nishiiba/Peghammer/README.md

# Peghammer  
Peghammerは漫画／イラスト用の自作無線左手デバイスです  

詳細は[ビルドガイド](docs/Index.md) をご確認下さい

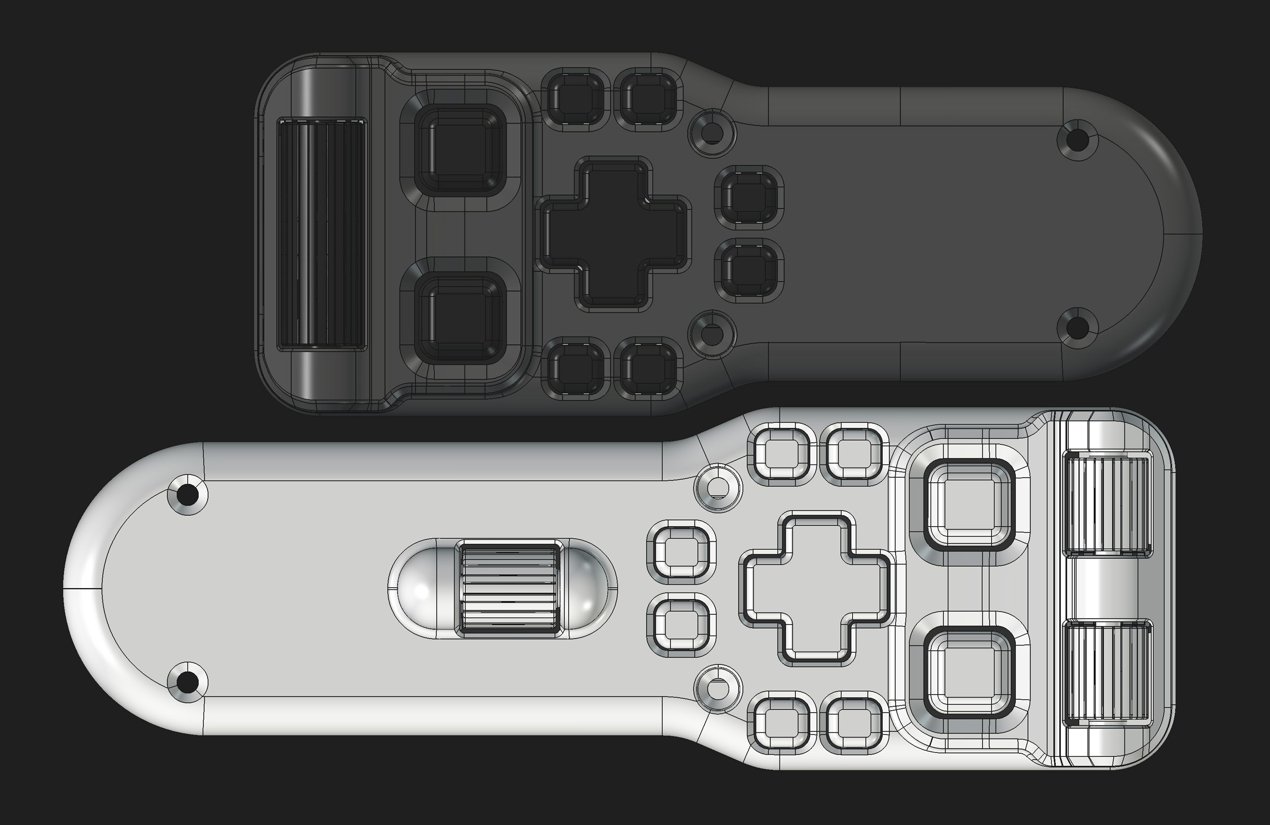
[picture p1: docs/image/top.jpg]
