nishiiba/Peghammer/PCB_3DP/README.md

## Peghammer – ハードウェア設計（PCBおよび3Dパーツ）

このディレクトリにはPeghammerのハードウェア設計ファイルが含まれています。

## 内容

- 基板データ（ガーバーファイル、ドリルファイルなど）
- 3Dモデルデータ（STL）

## ライセンス（ハードウェア設計）

このディレクトリにあるPeghammerのすべてのオリジナルハードウェア設計ファイル  
（PCB設計データおよび関連するオリジナルアセットを含む）はCC BY 4.0に基づいて公開されています。  

自由な利用: 複製、配布、商用利用、改変（改造・設計変更など）が可能です。  
主な条件: 利用時は必ず著作権者の表示を行ってください。また、改変した場合はその旨を明記してください。

---

## 謝辞／第三者提供資料

このハードウェア設計にはそれぞれの著作者の知的財産である  
第三者提供のフットプリントおよび回路図シンボルが含まれています。

これらの第三者提供資料はそれぞれのライセンスに従って使用されており  
本プロジェクトのCC BY 4.0ライセンスの対象外です。

これらの資料に関するすべての権利は元の作成者に帰属します。

クレジットは以下のとおりです。

###  BLE Micro Pro Assets (Footprints and Symbols)

BLE Micro Pro資料（フットプリントおよびシンボル）  
資料：MCUフットプリント、回路図シンボル  
作成者：sekigon-gonnoc  
ソース：https://github.com/sekigon-gonnoc/BLE-Micro-Pro/tree/master/bmp-boost  
ライセンス：MITライセンス  

## 免責事項（Disclaimer）

本ビルドガイド（以下「本ガイド」）に掲載された情報および配布データに基づいて作業を行う際は  
以下の免責事項を必ずお読みいただき同意の上で実施してください。

### 1. 設計データの現状有姿提供と無保証

* 本ガイドで配布・公開している各種設計データ  
（ガーバーデータ、3Dプリント用ケースデータ等以下「本データ」）  
はオープンハードウェアライセンス **CC BY 4.0** に基づいて提供されています。

* 本データは「現状有姿（As-Is）」で提供され明示・黙示を問わず  
その正確性、完全性、特定の目的への適合性あるいは動作の保証を含むいかなる種類の保証も行いません。

### 2. 製造・利用における自己責任

* 本データを利用してサードパーティ（基板製造メーカー、3Dプリントサービス等）への発注製造  
および組み立てを行う行為はすべて利用者の責任と費用において行ってください。

* データに起因する製造ミス、基板の不良、発注費用の損失  
あるいは組み立て中・使用中に発生したトラブルについて作成者は一切の責任を負いません。

### 3. 3Dプリントケースに関する免責

* 配布する3Dデータ（STL、STEP等）は作成者の環境で適合を確認したものですが  
利用者が使用する3Dプリンターの機種、スライサー設定、素材（フィラメント）の種類、収縮率  
または委託工場の仕様等によって印刷精度や仕上がりが異なります。  
ケースが基板（PCB）やスイッチと完全に嵌合（フィット）することを保証するものではありません。
 
* 素材の収縮や印刷誤差によりネジ穴の調整やヤスリがけ等の後加工が必要になる場合があります。  
これらの調整は利用者の責任において行ってください。

* 3Dプリントパーツの強度、耐熱性、経年劣化による破損  
または印刷失敗に伴うフィラメント費用の損失等について作成者は一切の責任を負いません。

### 4. 乾電池駆動に関する安全上の注意

* 本設計は乾電池駆動を想定しています。

* **充電式電池（ニッケル水素電池など）を装着した状態でUSBケーブルをPC等に接続して充電を行わないでください。**  
液漏れ、発熱、破裂、火災、および接続機器（PC等）の破損の原因となります。  

* 電池の極性（プラス・マイナス）を逆にして装着した場合の回路の破損や  
それに伴う事故・ケガ等について、当方は一切の補償をいたしません。

### 5. 損害賠償の不保持

* 本データおよび本ガイドの情報を利用したことにより生じた直接的・間接的な損害  
（キーボードの破損、接続機器の故障、データの損失、ケガ、火災など）について  
作成者は利用者または第三者に対して一切の法的な責任を負いません。
