nishiiba/Peghammer/docs/repl.md

# 部品が在庫切れの場合

<br>

①代替部品に変更  
②在庫切れ部品の予約注文  
③基板発注をPCBWAYに変更する  
④在庫切れ部品を自分で調達する

以上4つの方法があります

<br>

## ①代替部品に変更する
<br>

**代替部品に変更可能なのは以下の2箇所のみです**  

<br>

トリガー用スイッチ　C79178(標準部品) → C713479(代替部品)  
5方向スイッチ　C202415(標準部品) → C209766(代替部品)

<br>

トリガー用スイッチに代替部品を使う場合は  
スイッチキャップも変更が必要になります  
**[ここからc_repl.zipをダウンロード](https://github.com/nishiiba/peghammer/tree/main/PCB_3DP)**

<br>
<br>

欠品している部品は右端の部品編集から変更を行います  

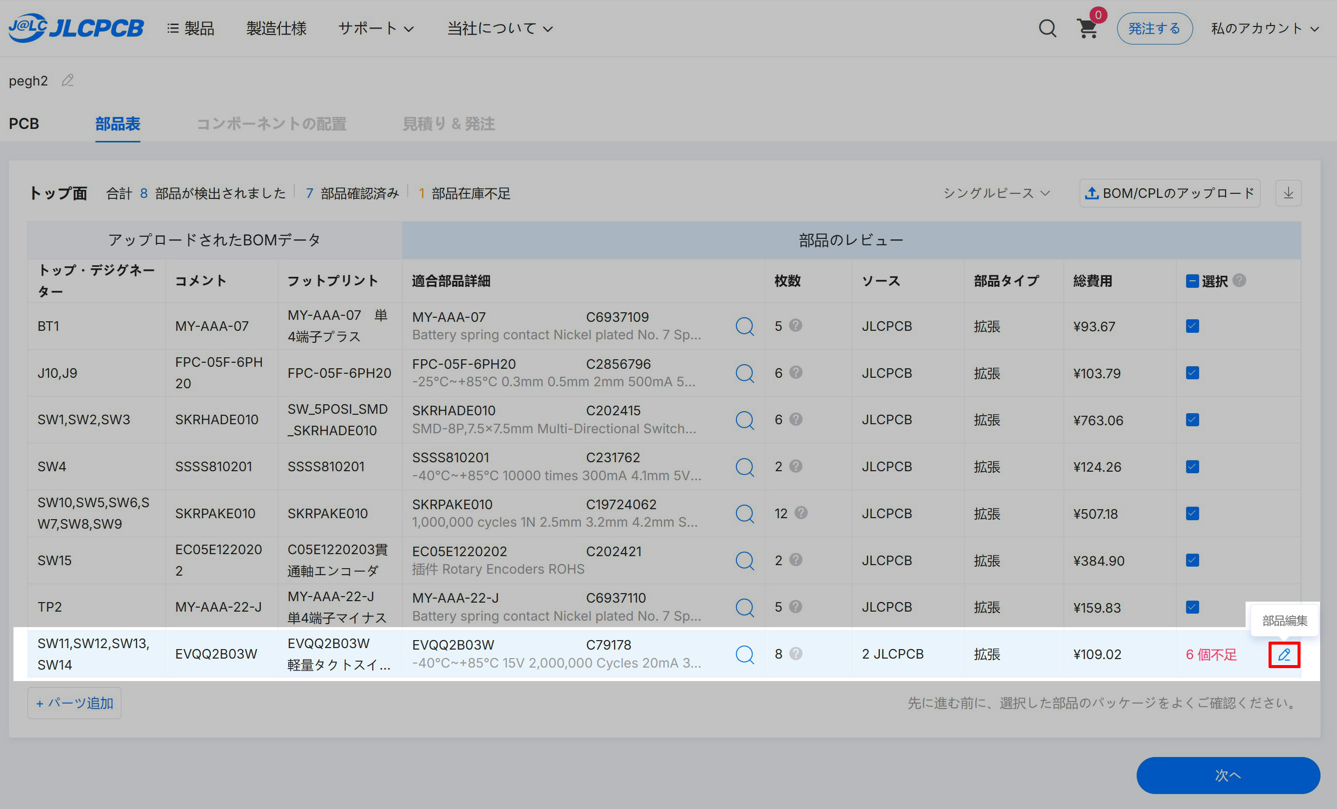
[picture p6: docs/image/r001.jpg]


<br>

以下の2箇所を消し

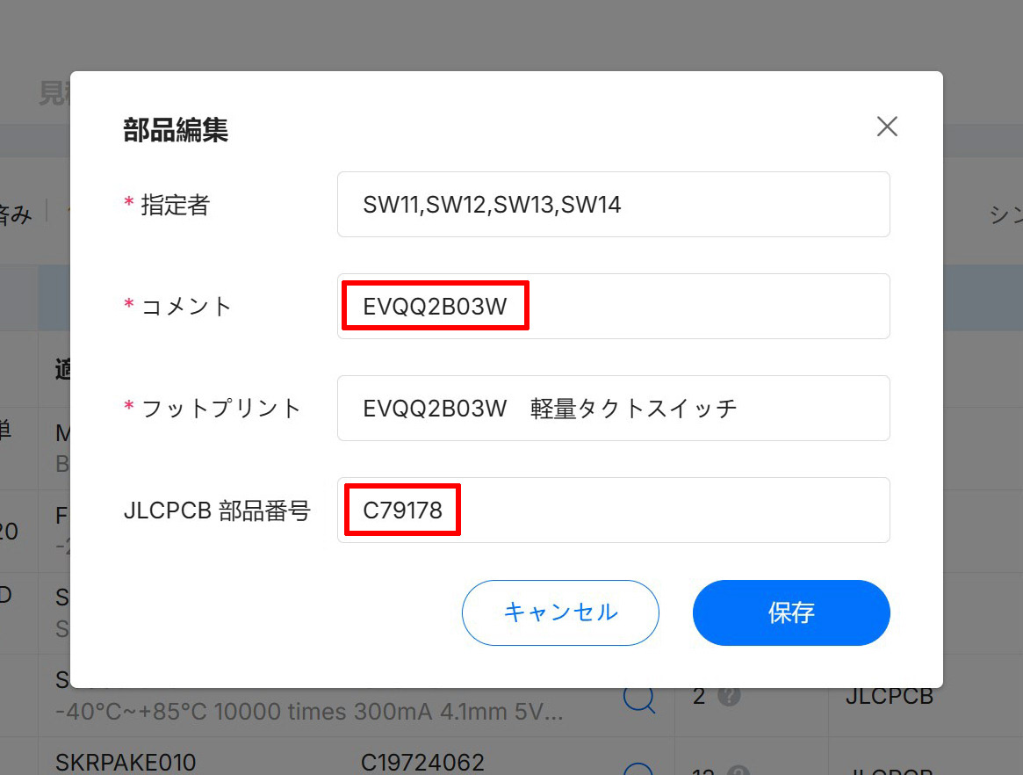
[picture p7: docs/image/r002.jpg]


<br>

代替部品の番号を記入して保存を押します

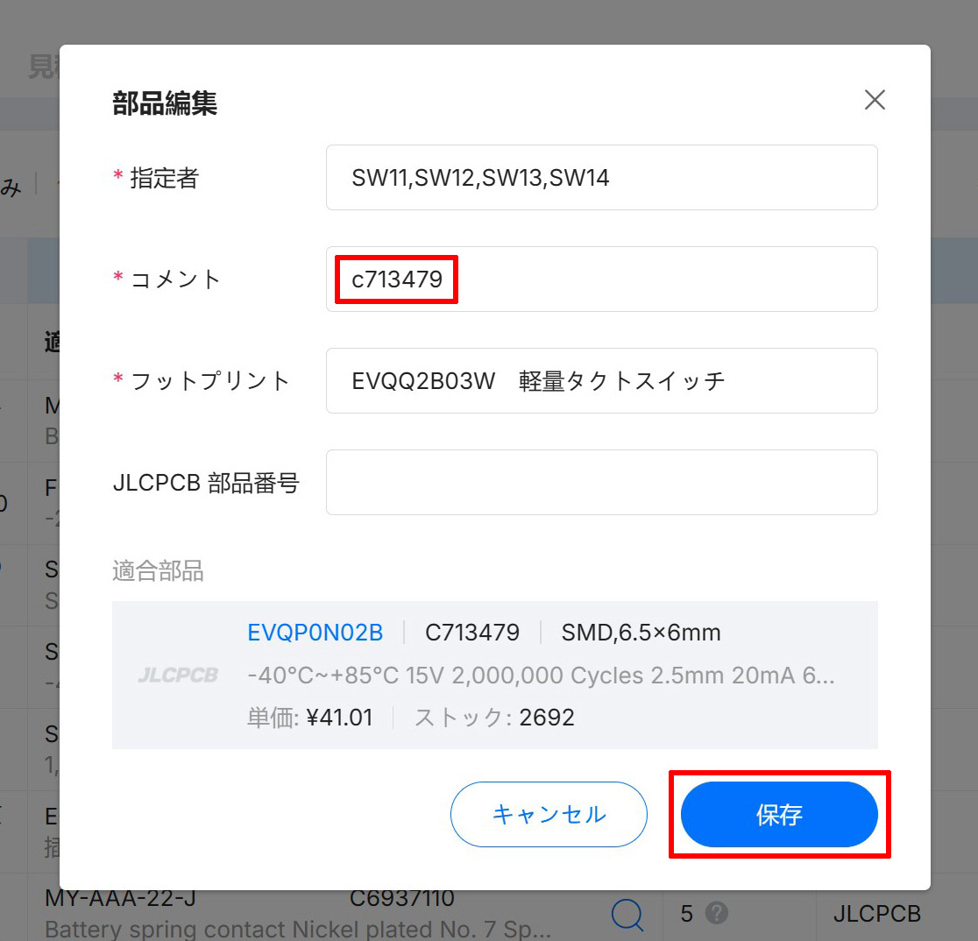
[picture p8: docs/image/r003.jpg]


<br>

チェックを入れて変更完了です

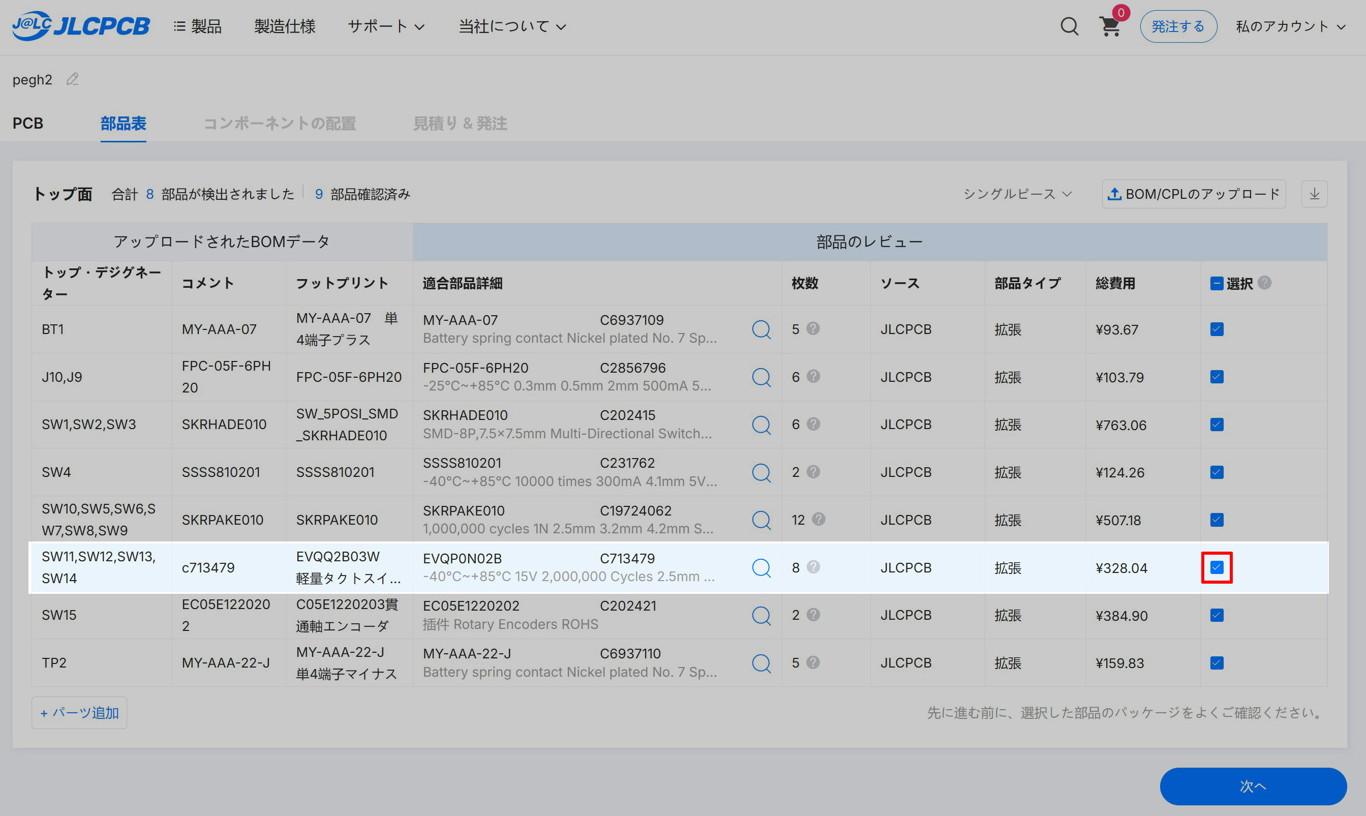
[picture p9: docs/image/r004.jpg]


<br>
<br>

## ②在庫切れ部品の予約注文  

<br>

在庫切れ部品を予約購入して自分用にストックしておき  
PCBAを発注する際はそこから使用する方法です

<br>

在庫切れ部品の管理番号(Cから始まる番号)をコピーして  

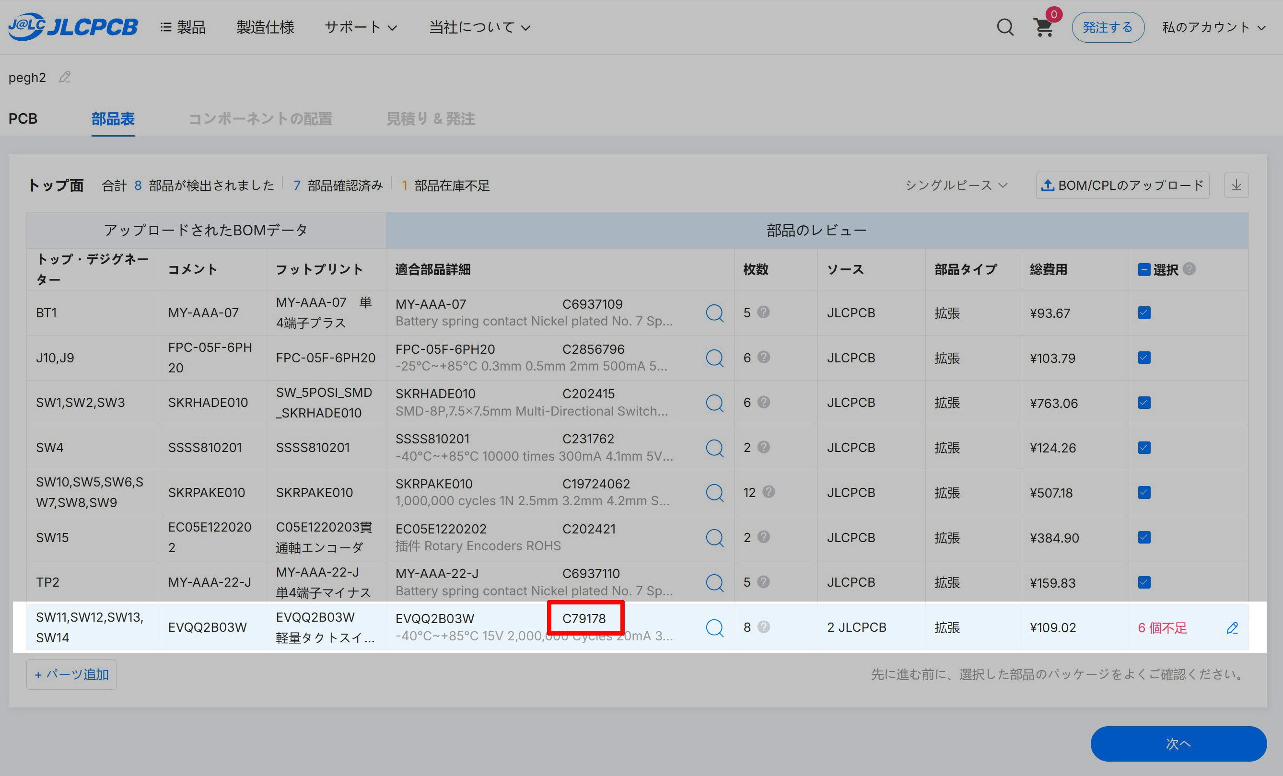
[picture p10: docs/image/r005.jpg]


<br>

アカウントページ左側のParts ManagerからJLCPCB Partsに移動 

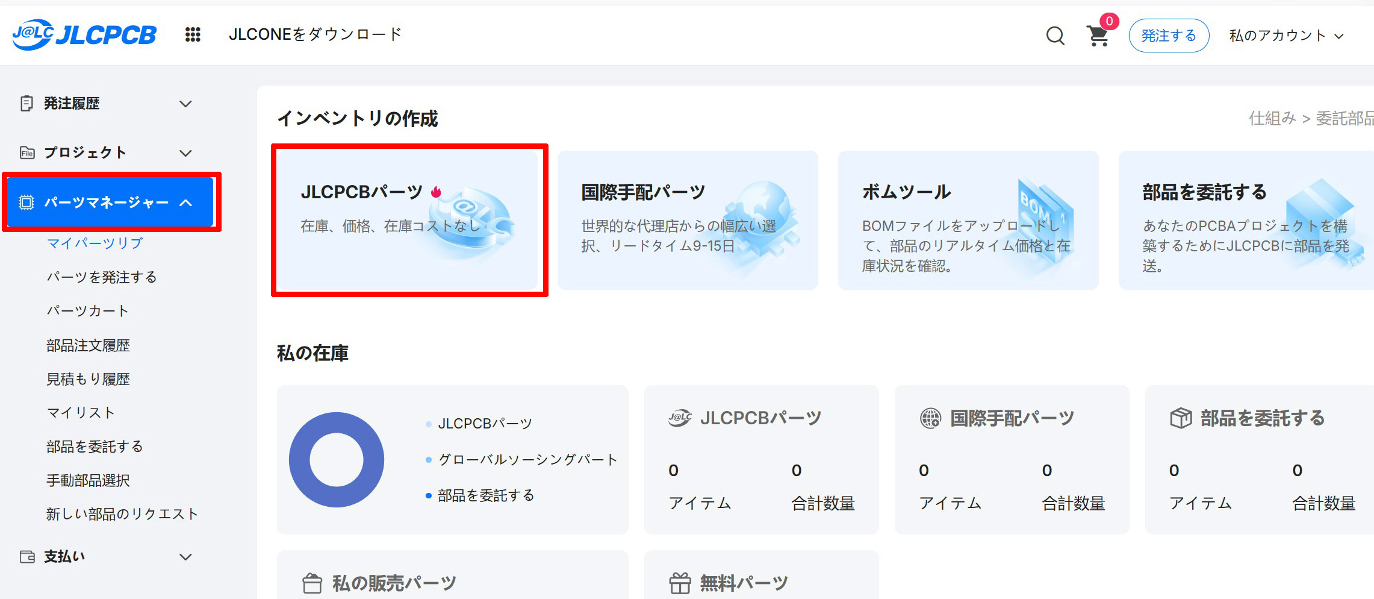
[picture p11: docs/image/r006.jpg]


<br>

上の検索バーに部品の管理番号を貼り付けて検索をしてください 

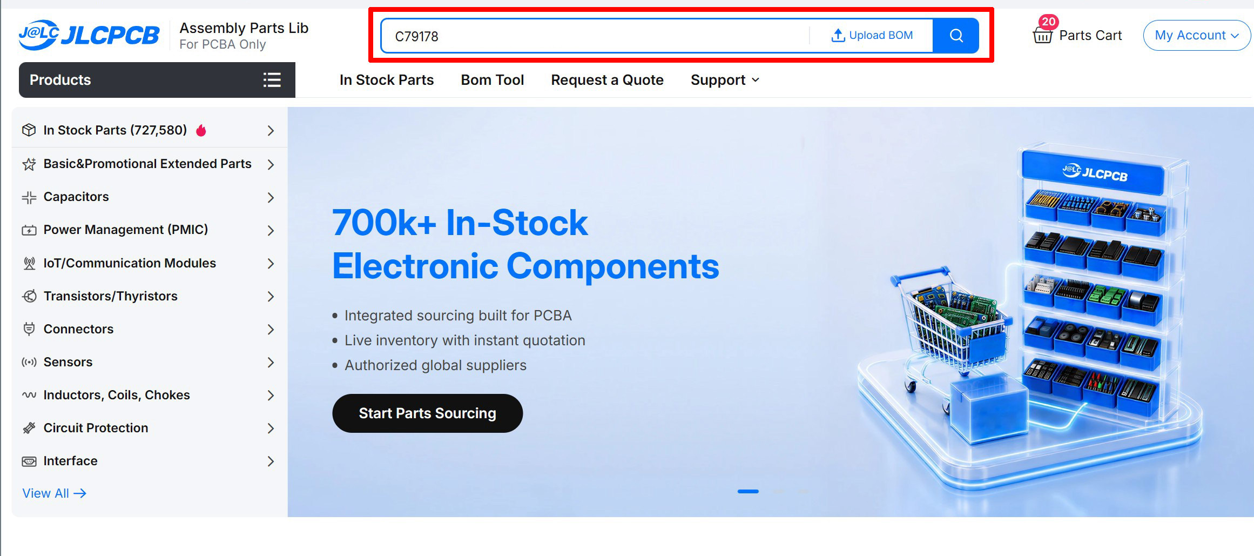
[picture p12: docs/image/r007.jpg]


<br>

在庫切れ部品のページがヒットするのでそこから予約注文を行います  

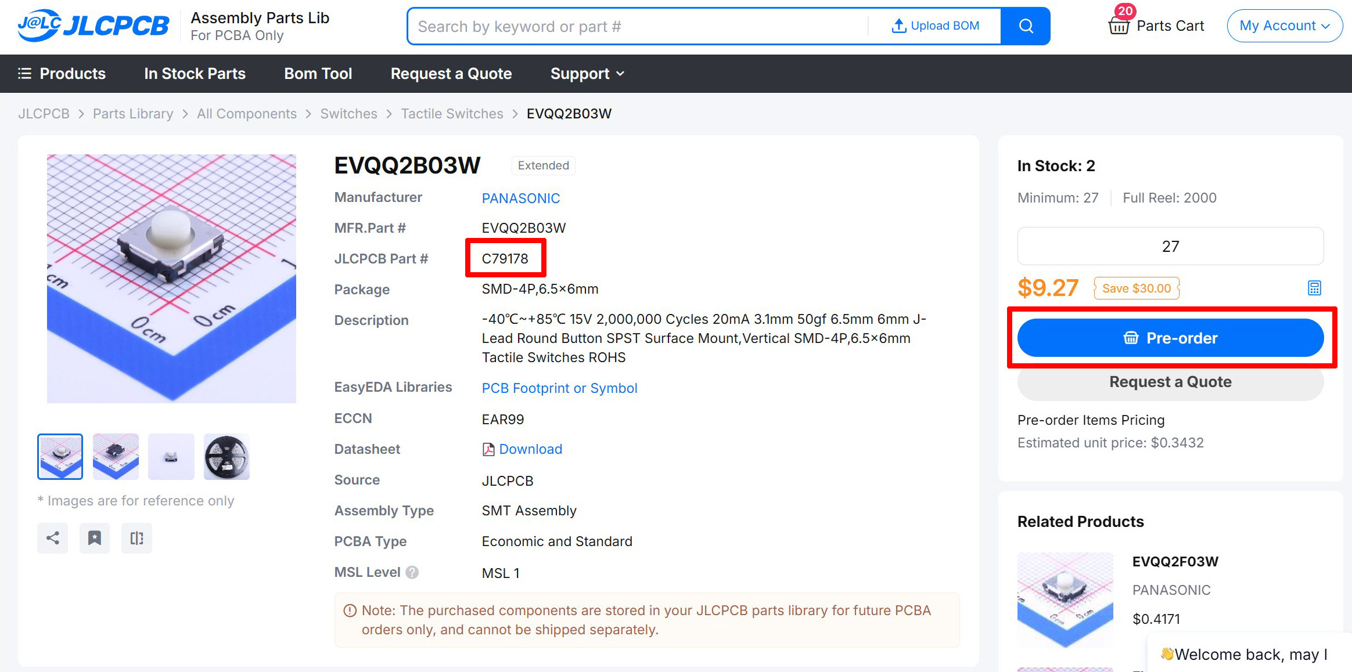
[picture p13: docs/image/r008.jpg]


<br>

取り寄せまで時間がかかる事と  
部品によっては最低購入数が多めに設定されていて  
費用がかさんでしまうことがネックです

<br>
<br>

## ③基板発注をPCBWAYに変更する  

<br>

JLCPCBは自社(LCSC)のパーツ在庫を使用するのに対し  
PCBWAYはDigiKeyやMouserなど複数の国際的な卸業者から  
部品を取り寄せているので在庫が安定しているようです

私はこちらを利用したことがないため変更する際は  
｢PCBWAY PCBA 発注方法｣ で調べてみて下さい

<br>
<br>

## ④在庫切れ部品を自分で調達する

<br>

在庫切れ部品は除外して発注を進め  
部品は自分で調達､取り付けを行う方法です

専用の道具が必要になり取り付けも簡単ではないので  
電子工作に慣れた人以外はおすすめしません

<br>
<br>

#### [戻る](order_1.md#部品リストの確認)

<br>
<br>

---

このビルドガイド（文章・画像）は [CC BY 4.0](https://creativecommons.org/licenses/by/4.0/deed.ja) の下に提供されています。

Copyright (c) 2026 nishiiba
