nishiiba/Peghammer/docs/ts.md

# トラブルシューティング
<br>

試作段階で実際に起きた不具合や対処をまとめています   
フラックス(はんだの補助剤)によるトラブルは手はんだで組み立てた基板でのみ確認しています

<br>

---

## Bluetooth接続でPCやiPadとペアリングできない

ペアリングできない､または頻繁に接続が切れる場合は以下の方法を試して下さい

<br>

①マイコンにリセット用ファイルを書き込んで接続情報をリセット  
②PC側のBluetooth接続情報を消去  
③ファームウェアを書き込み  
④再度ペアリング

<br>

それでも接続できない場合はリセット用ファイルで  
接続情報を消しきれていない可能性があります  
以下の方法も試して下さい

<br>

①PCとUSB接続をしてDYA Studioを開く  
②どれかのボタンにBluetoothビヘイビアのClear All Profilesを設定  
③設定したボタンを押してマイコン内のBluetooth接続情報を全消去  
④再度ペアリング  

<br>

---

## 5方向スイッチのノブがゆるくて抜けてしまう

秋月電子のジョイスティック(5ポジションスイッチ)DIP化キットと  
エポキシ接着剤を使い以下の手順で修正をして下さい

<br>

①ジョイスティックキットのピンにリップクリームを薄く塗る  
②スイッチノブの差し込み穴内側にエポキシ接着剤を薄く塗る  
③ジョイスティックキットのピンに差し込み接着剤が固まるまで待つ  
④ノブを外して5方向スイッチに取り付ける

<br>

接着剤による修正は必ずジョイスティックキットを使って下さい  
デバイス本体の5方向スイッチを使用すると接着剤がスイッチの隙間に入り込んで  
固着してしまう可能性があります

エポキシ接着剤は5分硬化のものが使いやすいです

<br>

---
## レジン部品が大きく歪んでいる

レジン部品の歪みは以下の手順で修正ができます

<br>

①沸騰させたお湯を使い捨て容器に入れる  
②レジン部品を熱湯に1分ほど漬ける  
③柔らかくなったレジンを取り出し歪みを矯正した状態で水をかける

<br>

調理鍋などで直接レジンを煮ると有害成分が溶け出し鍋に付着してしまうので  
必ず使い捨て容器を使って下さい

<br>

---
## スイッチが押しっぱなしになる

組立時に付着したフラックスの洗浄不良  
または何らかの汚れでスイッチがずっと通電した状態になっています  
以下の手順で不具合の出ているスイッチに電子部品用洗浄剤を使用して下さい

①分解して基板から取り外せる部品はすべて取り外す  
②洗浄剤をスイッチの中に浸透するよう多めに吹きかける  
③キッチンペーパーなどで拭き取ってから組み立てます  

どのスイッチが押しっぱなしになっているか分からない場合は  
キーボードテストサイトで確認して下さい

<br>

---
## スイッチの反応が鈍い､反応しない

電池切れ直前になると遅延が発生してスイッチの反応が悪くなることがあるので  
まず電池交換を試して下さい

<br>

電池交換で直らない場合は分解してすべてのピンやコネクタが正しく差し込まれているか確認して下さい

<br>

正しく差し込まれている場合スイッチの接点不良の疑いがあります  
以下の手順で不具合の出ているスイッチに電子部品用洗浄剤を使用して下さい

<br>

①分解して基板から取り外せる部品はすべて取り外す  
②電子部品用洗浄剤をスイッチの中に浸透するよう少量吹きかける  
③キッチンペーパーなどで拭き取ってから組み立て  
④スイッチを連打していると徐々に症状が収まってきます  

<br>

電子部品洗浄剤を試して効果がなかった場合  
接点復活剤に変えて同じ手順を試してみて下さい  

どちらを試しても効果がなく､組み立て直後から不具合が出ている場合は  
スイッチ自体が不良品の可能性が高いです  
はんだ付け作業でスイッチ交換をするか基板ごと交換をして下さい

<br>

---
## 交換用の基板を単体で発注したい

メイン基板､電池基板､トリガー基板を単体で発注(PCBA)する場合は    
[PCB_repl.zip](https://github.com/nishiiba/peghammer/tree/main/PCB_3DP)を使用して下さい

発注時は 
異なるデザイン｢1｣　納品形式｢面付けなし｣　を選択して下さい  
後は基板発注ページの手順と同じです

<br>

---

## 不良部品を交換したい

**※はんだ付けが必要な作業です**

部品は基板の片面にのみ取り付けられているので  
小型のリフロー用ホットプレートとはんだごてを使用してピンポイントで部品交換が可能です

<br>

①ケースを分解して取り外せる部品はすべて取り外す  
②外したい部品の裏からリフロー用ホットプレートで加熱する  
③はんだが溶けたらピンセットで部品を取り外す  
④他の部品が取れないように慎重にホットプレートから下ろして冷ます  
⑤端子に残ったはんだをはんだごてとはんだ吸い取り線で除去し電子部品洗浄剤で汚れを落とす  
⑥端子部分にペーストはんだを薄く塗って新しい部品を設置する  
⑦ホットプレートではんだ付けを行う  

<br>

リフロー用ホットプレートはMHP30がおすすめです

<br>

---

<br>

#### [戻る](Index.md#目次)

<br>
<br>

---

このビルドガイド（文章・画像）は [CC BY 4.0](https://creativecommons.org/licenses/by/4.0/deed.ja) の下に提供されています。

Copyright (c) 2026 nishiiba
