nishiiba/Peghammer/docs/image/b002.jpg

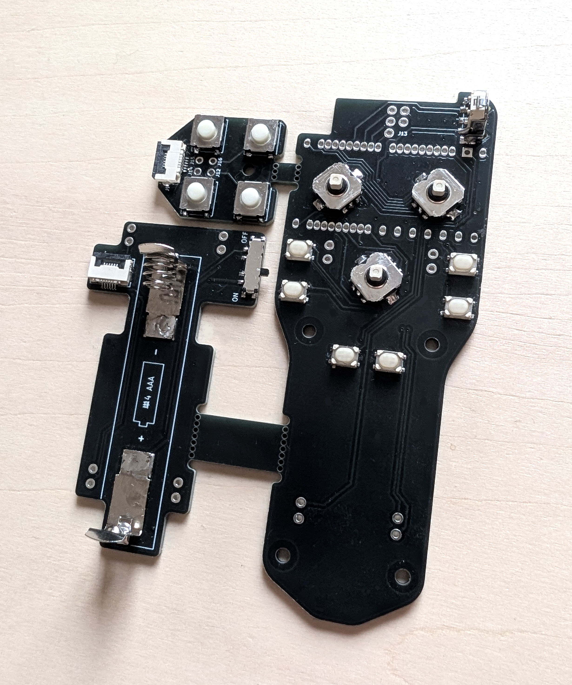
docs/image/b002.jpg
