nishiiba/Peghammer/docs/image/o016a.jpg

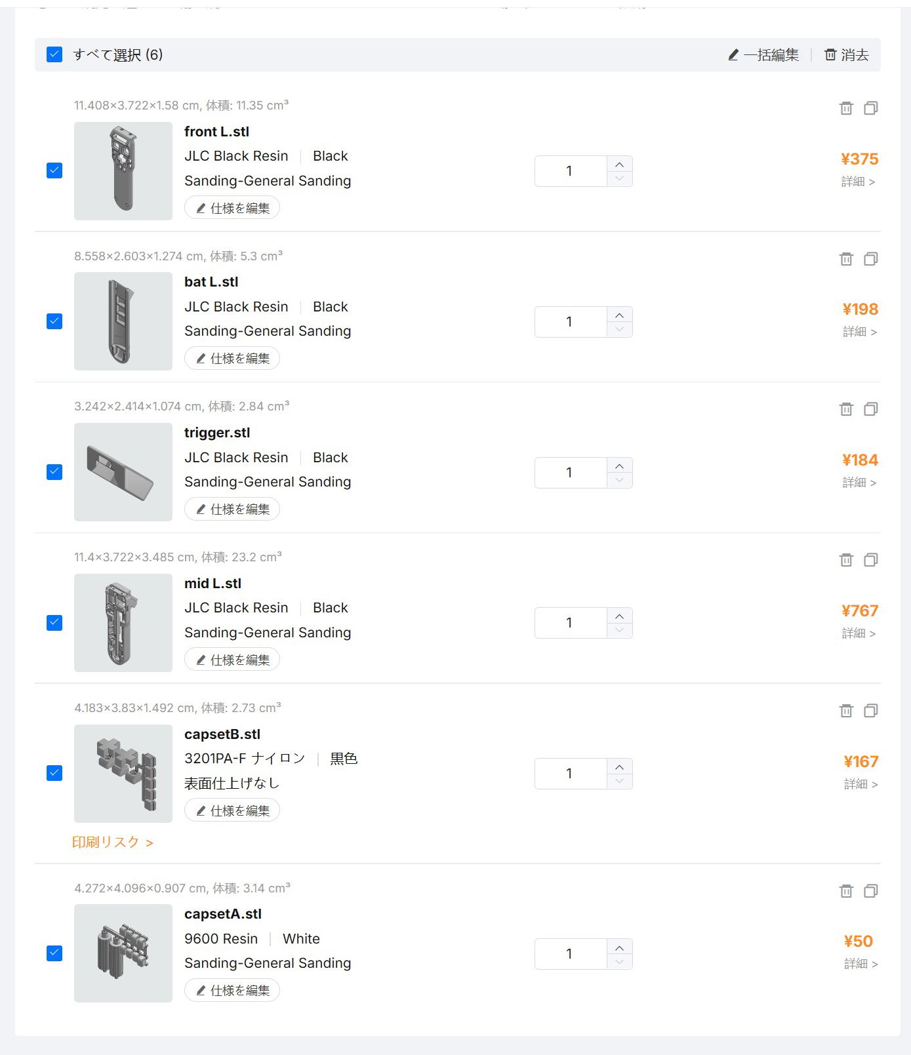
docs/image/o016a.jpg
