nishiiba/Peghammer/docs/image/s003g.jpg

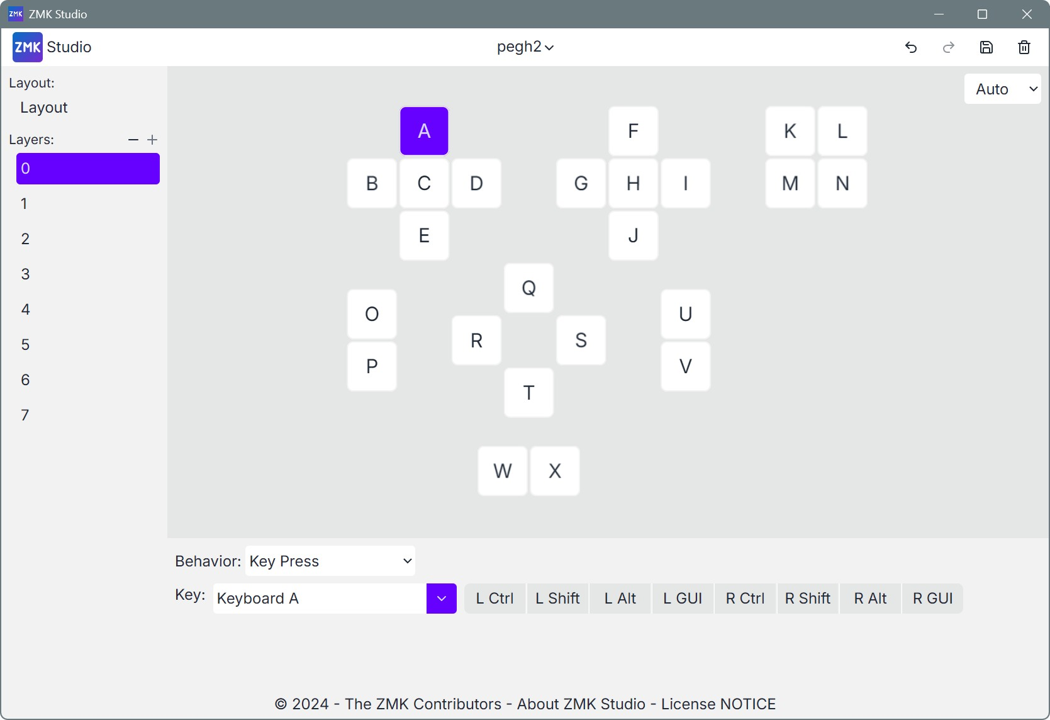
docs/image/s003g.jpg
