nishiiba/Peghammer/docs/image/s013.jpg

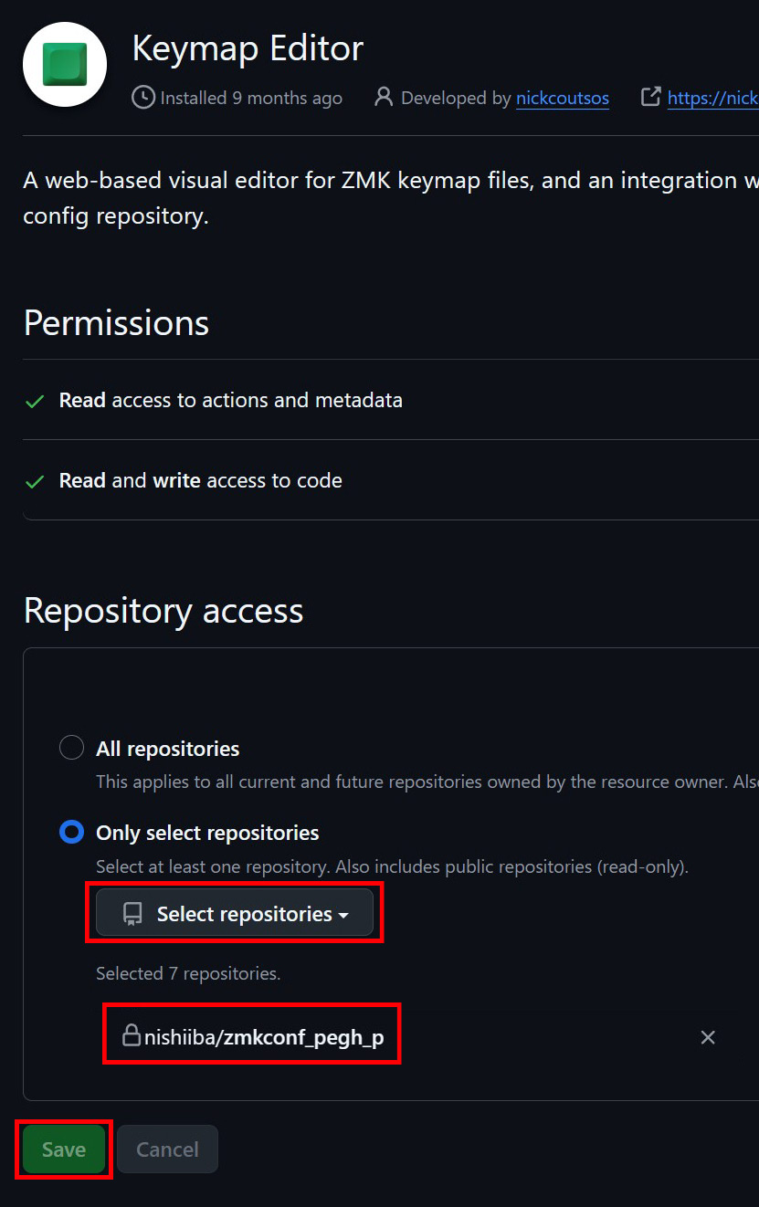
docs/image/s013.jpg
