nishiiba/Peghammer/docs/image/s015.jpg

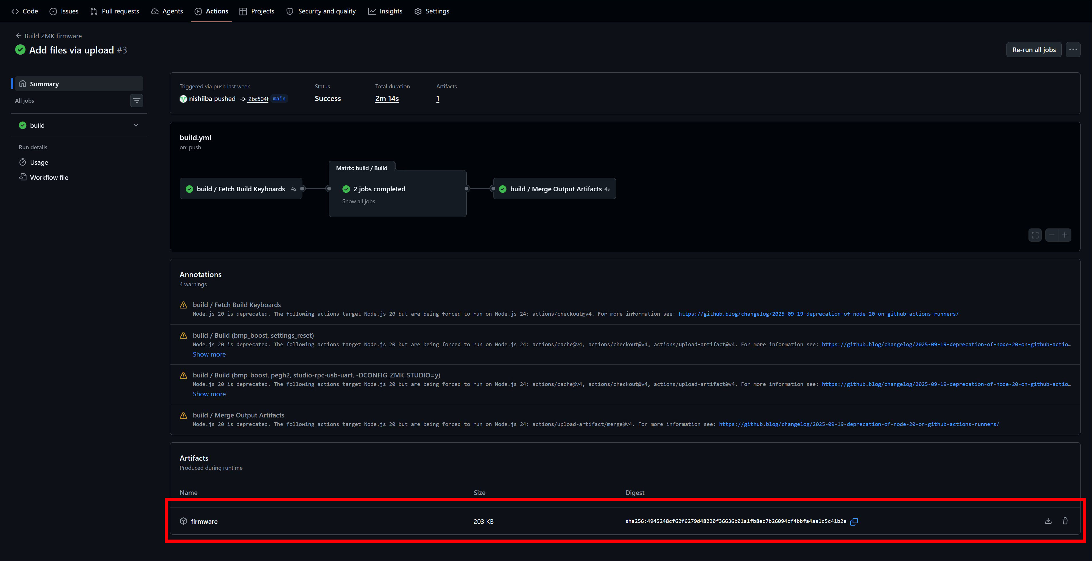
docs/image/s015.jpg
