nishiiba/Peghammer/docs/image/s016.jpg

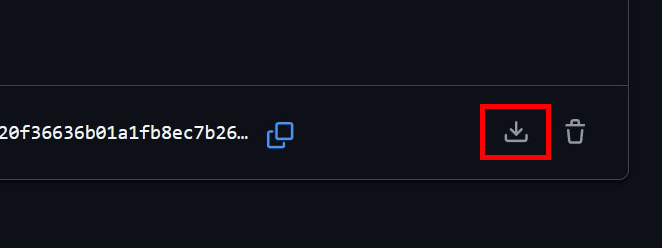
docs/image/s016.jpg
