nishiiba/Peghammer/docs/image/s020.jpg

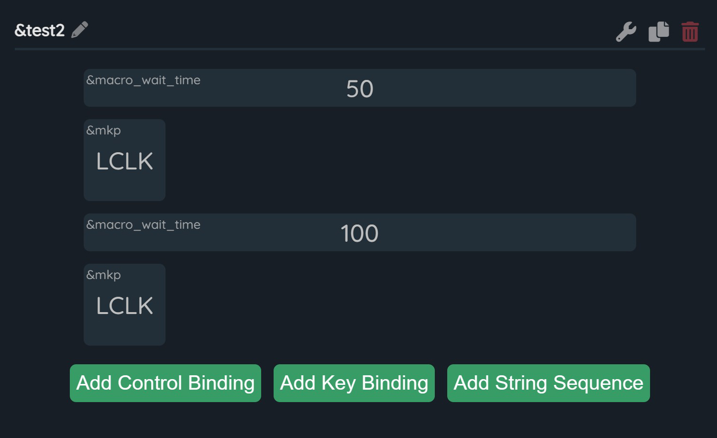
docs/image/s020.jpg
