nishiiba/Peghammer/docs/order_2.md

# 3Dプリント部品の発注

<br>

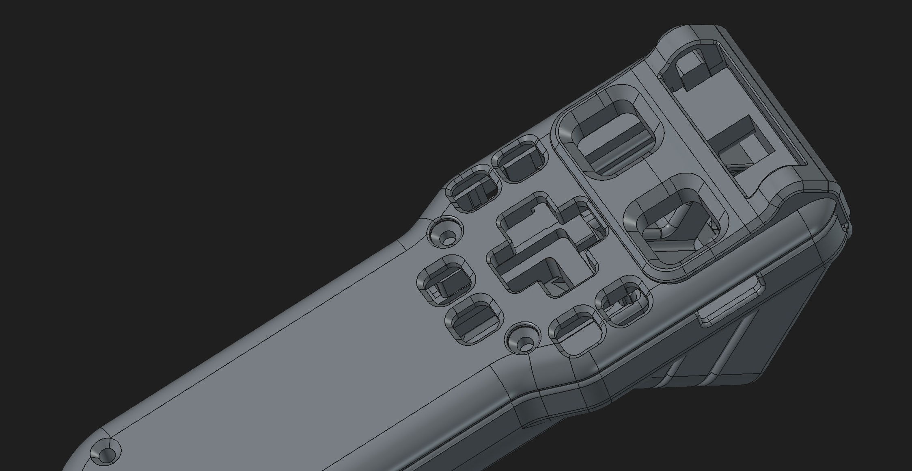
[picture p47: docs/image/o016b.jpg]


<br>

①発注用データのダウンロード
-

<br>

**[ここからzipファイルをダウンロード ](https://github.com/nishiiba/peghammer/tree/main/PCB_3DP)**  
データの使用はREADMEを読んで自己責任でお願いします  

<br>

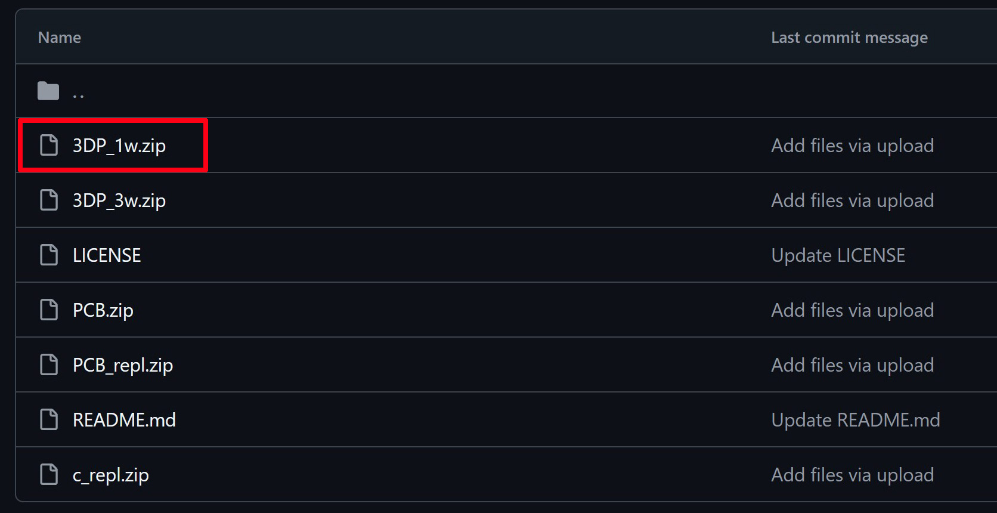
[picture p48: docs/image/i002b.jpg]


<br>

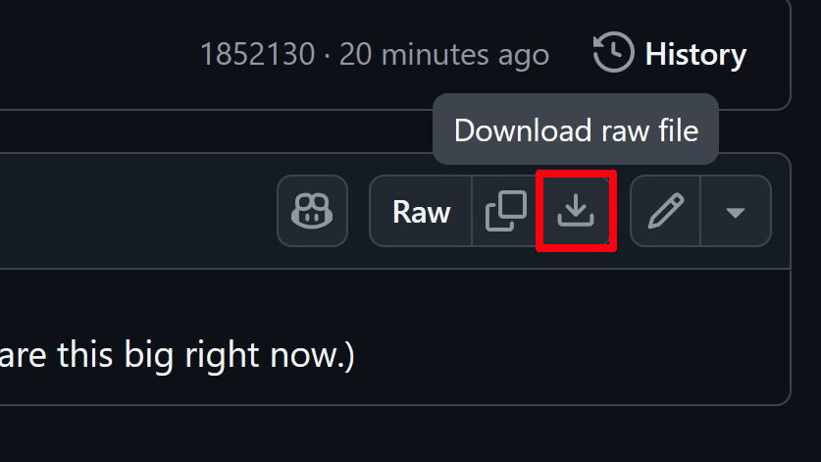
[picture p49: docs/image/i003.jpg]


<br>

<br>

②データのアップロード
-

<br>

3Dプリント注文ページからSTLファイルをアップロードします

<br>

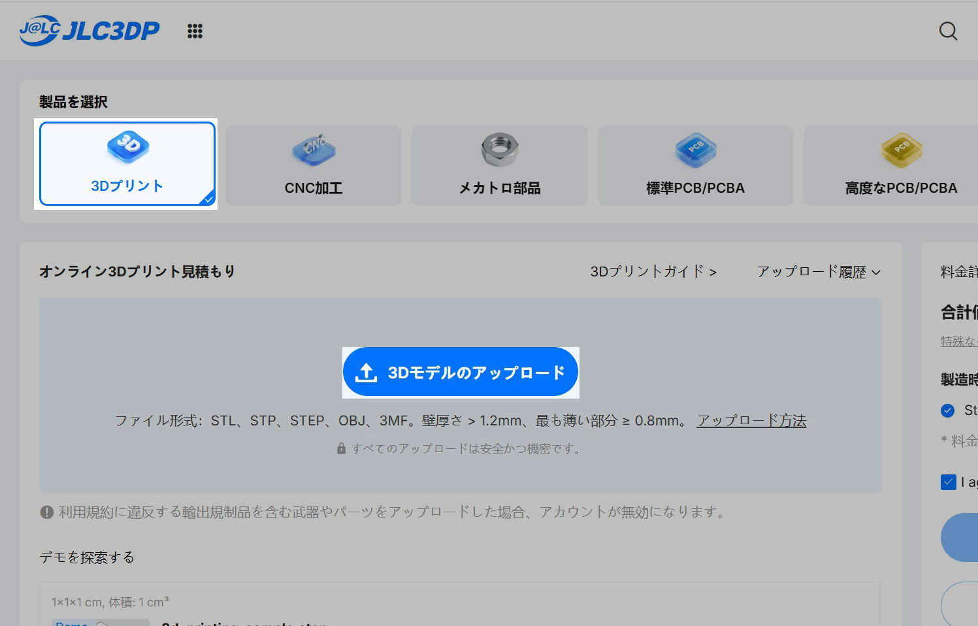
[picture p50: docs/image/o016.jpg]


<br>

---
**SLSフォルダ**

スイッチキャップ類はすべてSLS方式で  
素材は以下のどちらかを選んで発注して下さい    

･3201PA-Fナイロン(黒)  
･1172Proナイロン(白)    

<br>

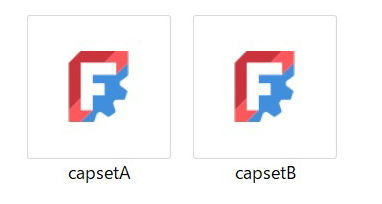
[picture p51: docs/image/o017.jpg]


<br>

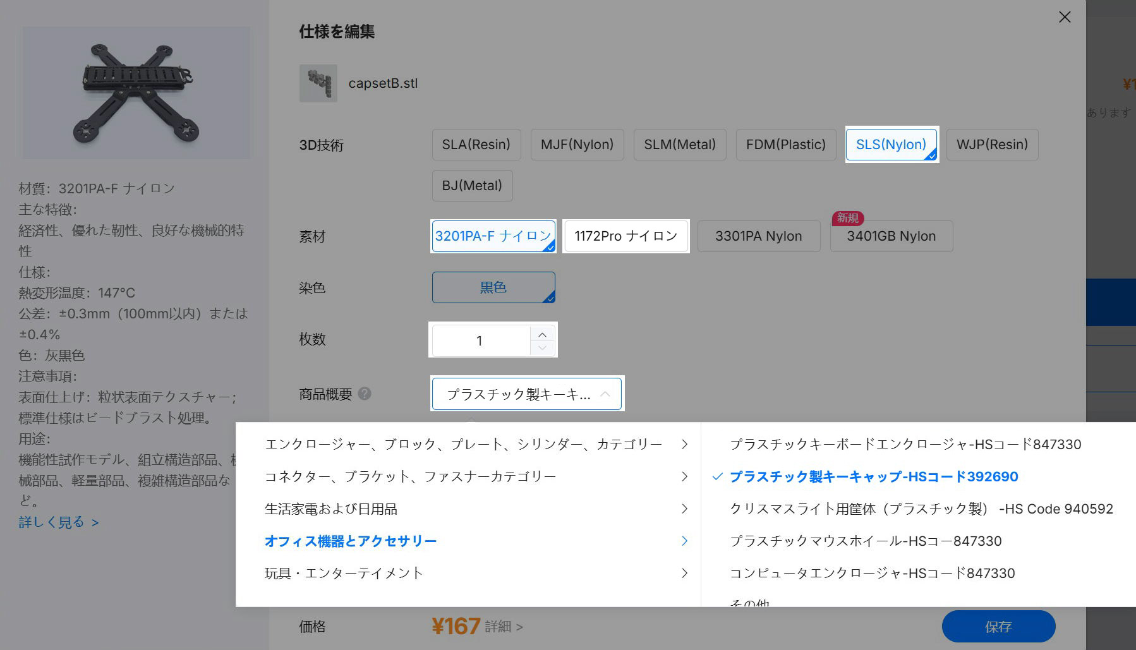
[picture p52: docs/image/o018.jpg]


<br>

商品概要はこのように選択して下さい

<br>

---
**SLAフォルダ**  

ケース部品は4サイズから1つ選んでSLA方式で発注します  

･Lサイズ  
･Lサイズショートトリガー  
･Sサイズ  
･Sサイズショートトリガー  

<br>

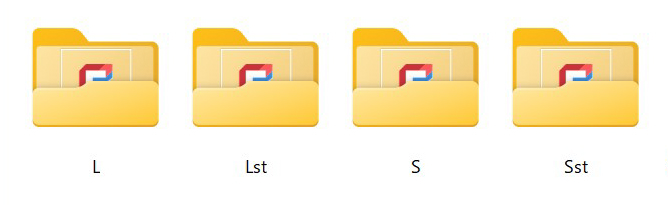
[picture p53: docs/image/o019.jpg]

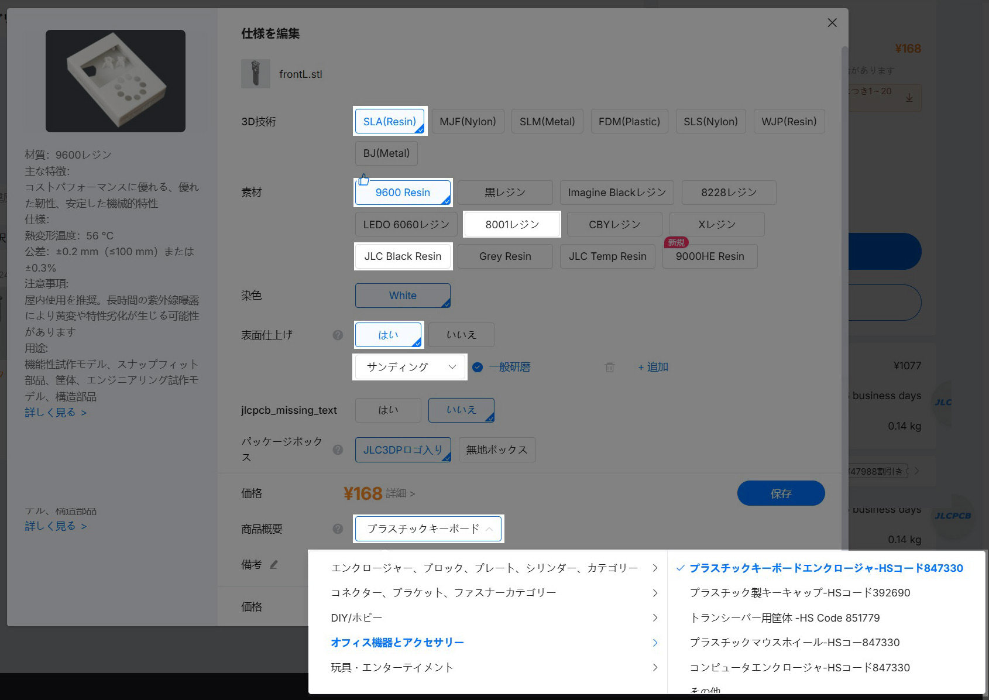
[picture p54: docs/image/o020.jpg]


<br>

素材は以下の3種類から選んで下さい  

･9600Resin(白)  
･JLC Black Resin(黒)  
･8001(透明)  

8001(透明)は少し割高ですが透明度の高いクリアケースに仕上げてくれます

<br>

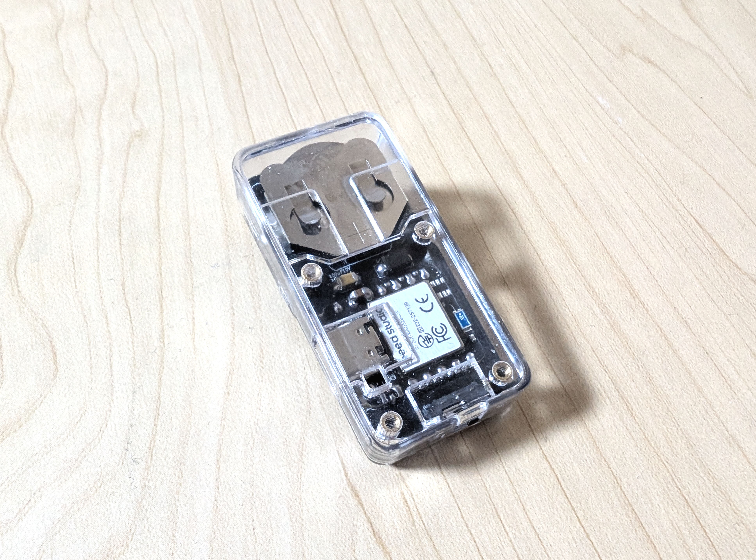
[picture p55: docs/image/o021.jpg]


<br>

**3Dプリントの積層痕を磨くサンディングオプションは必ず選んで下さい**  
**なしを選んでしまうと仕上げをしていない凸凹の状態で届きます**  

<br>

上記以外の素材でも問題ないかもしれませんが  
テストをしていないので歪みや嵌合はどうなるか分かりません

<br>

③チェックアウト
-

<br>

こちらも発送方法はOCSを選択します  

<br>

④印刷リスクのチェックと支払い
-

<br>

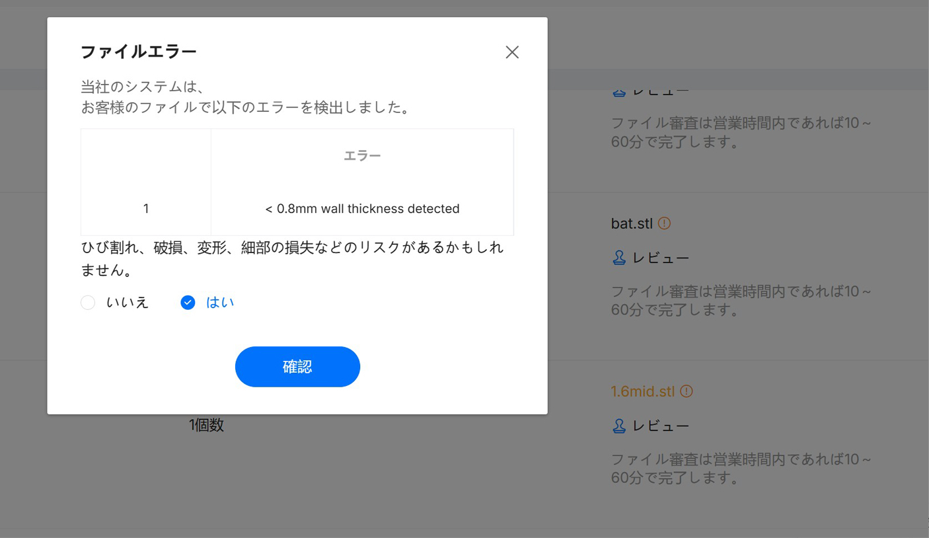
[picture p56: docs/image/o022.jpg]


<br>

発注後､各部品に印刷リスクの注意が出たら｢はい｣にチェックを入れて下さい  
部品は一通り試作を行っているので問題はないかと思います

<br>

データの審査が終わると発注履歴のページから支払いが出来るようになります  
**こちらも初回クーポンを必ず適用して下さい**

<br>

基板と3DP部品は支払いからだいたい10日くらいで届きます  
部品が使用できないほど大きく変形している場合は  
履歴のページから写真を添えて品質クレームを入れると作り直してもらえます  

<br>

<br>

#### [戻る](Index.md#目次)

<br>
<br>

---

このビルドガイド（文章・画像）は [CC BY 4.0](https://creativecommons.org/licenses/by/4.0/deed.ja) の下に提供されています。

Copyright (c) 2026 nishiiba
