nishiiba/Peghammer/docs/ph.stl

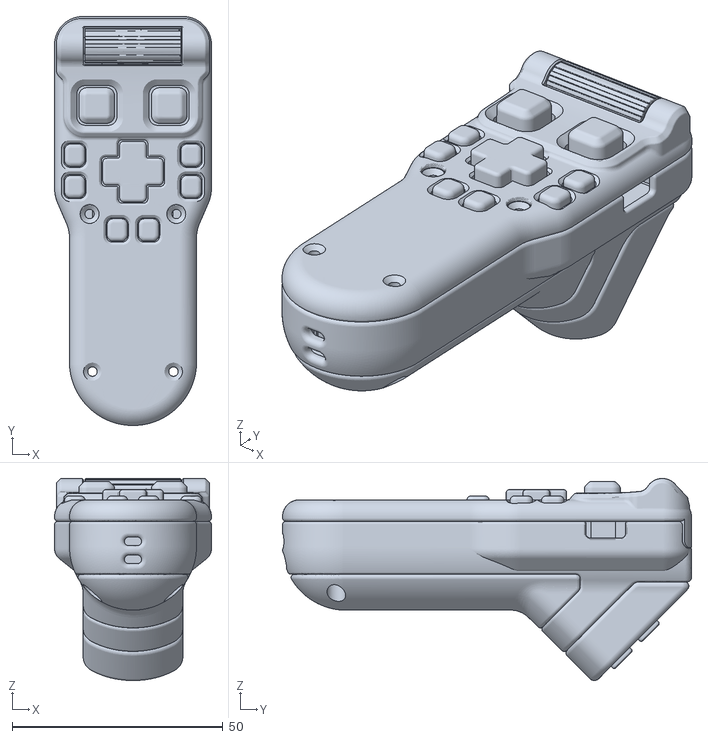
[picture p75: CAD file, 2026-09-01]
docs/ph.stl
37.2 x 97.0 x 47.9
