nishiiba/Peghammer/docs/ph3w.stl

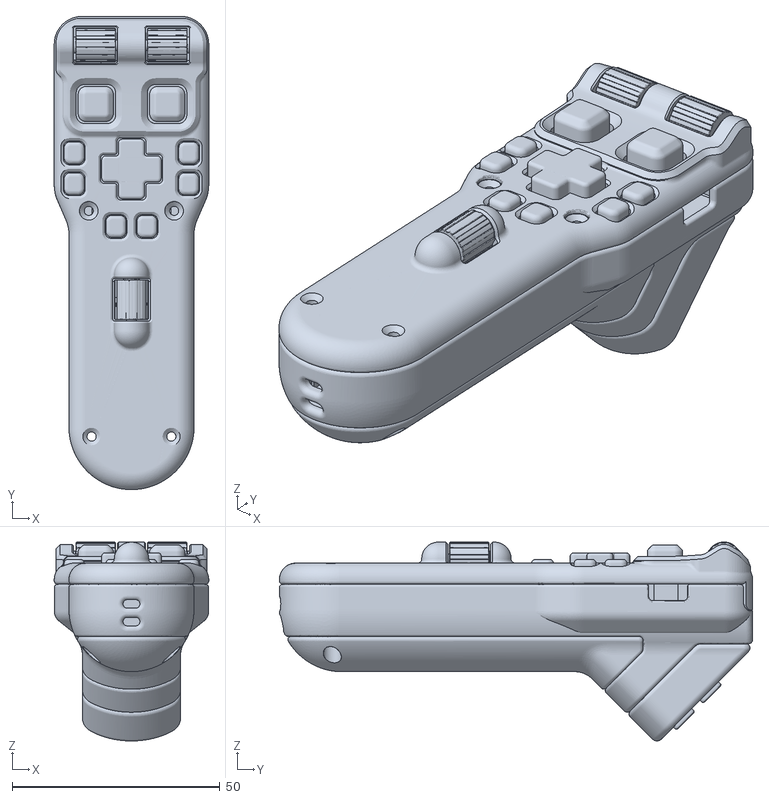
[picture p76: CAD file, 2026-09-01]
docs/ph3w.stl
37.2 x 114.0 x 47.9
