nishiiba/Peghammer/(commit log)

2026-09-06 Update DYA Studio button configuration guide
2026-09-22 Update build manual for soldering instructions
